kaymies/swing_jump_win/CAD/Project Reference CAD/Gantry Reference/treadmill_pic.jpg

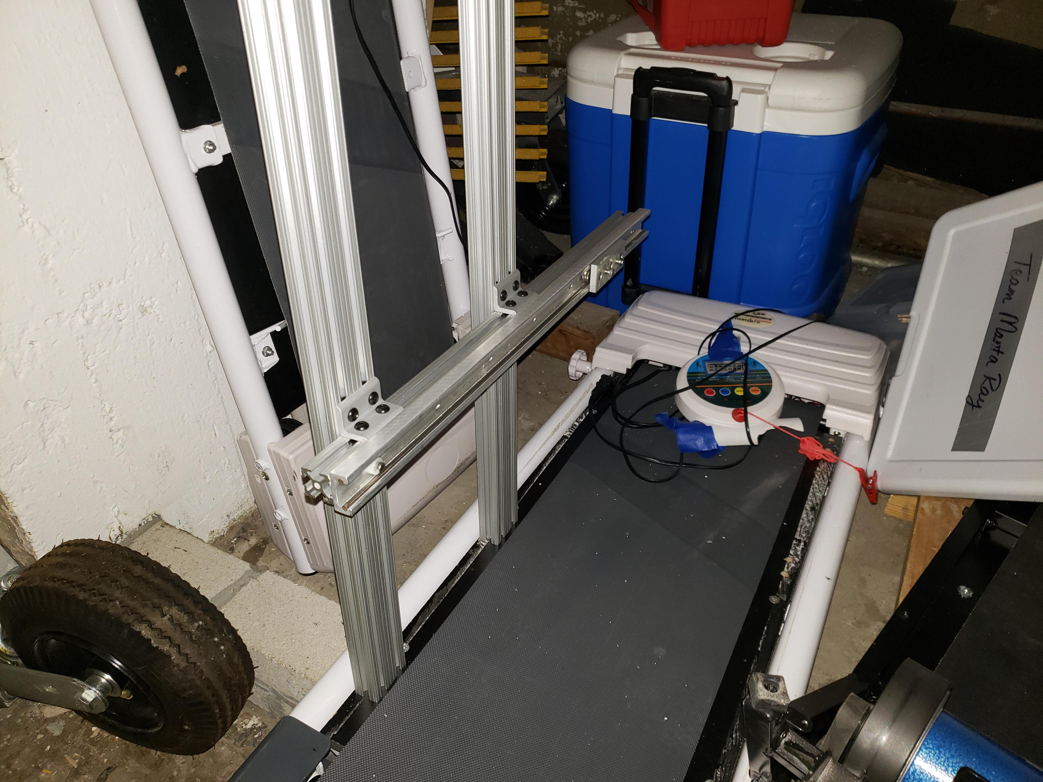
CAD/Project Reference CAD/Gantry Reference/treadmill_pic.jpg
