kaymies/swing_jump_win/README.md

# swing_jump_win
Code for simulating and programming a jumping robot with arms
