kaymies/swing_jump_win/CAD/modified_1dof_jumping_jig/Figures/Complete_1.PNG

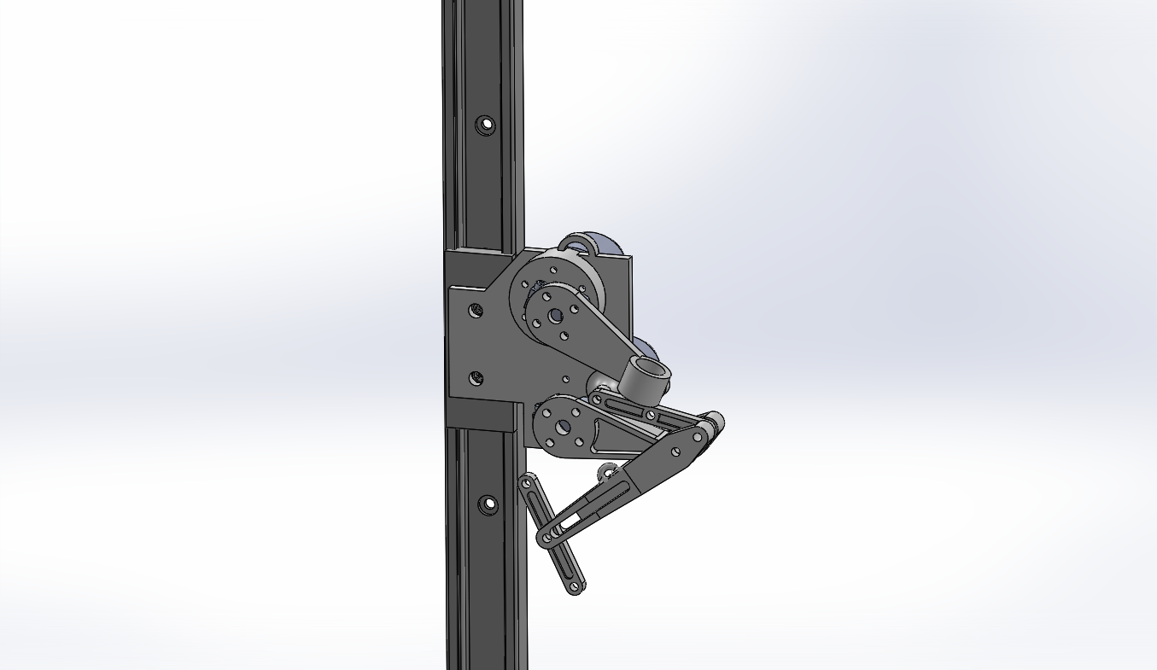
CAD/modified_1dof_jumping_jig/Figures/Complete_1.PNG
