kaymies/swing_jump_win/CAD/modified_1dof_jumping_jig/Figures/Complete_1_front.PNG

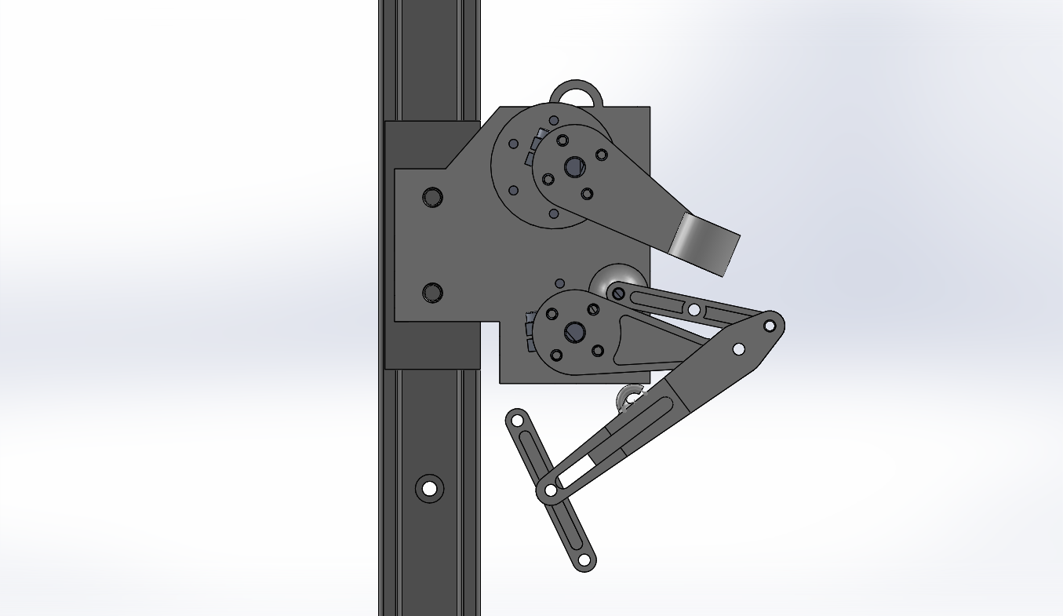
CAD/modified_1dof_jumping_jig/Figures/Complete_1_front.PNG
