kaymies/swing_jump_win/CAD/Project Reference CAD/Gantry Reference/Slider_pic.jpg

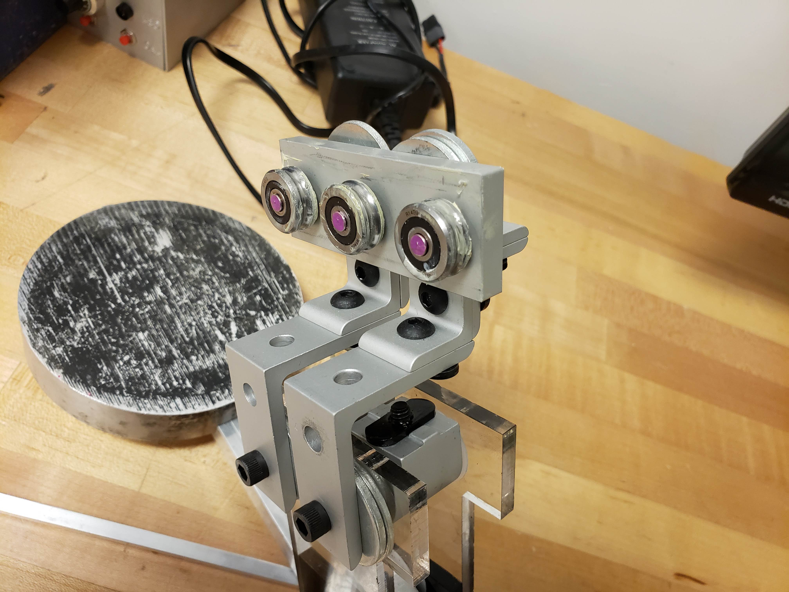
CAD/Project Reference CAD/Gantry Reference/Slider_pic.jpg
