kaymies/swing_jump_win/Modeling/Structure_Drawing.jpg

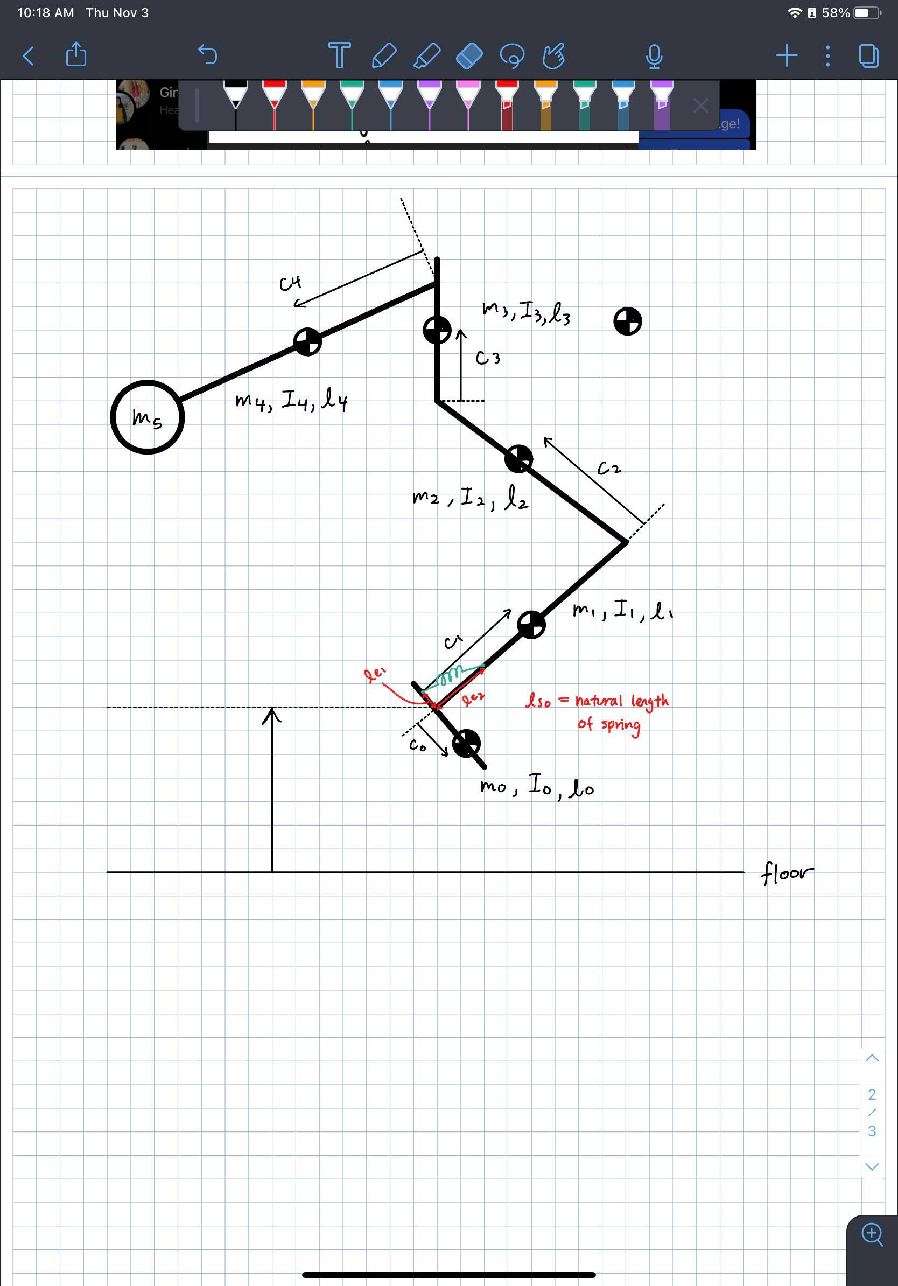
Modeling/Structure_Drawing.jpg
