kaymies/swing_jump_win/CAD/Material.txt

Pulley (Mcmaster):
https://www.mcmaster.com/3213T52
