kaymies/swing_jump_win/CAD/Project Reference CAD/Boom Reference/Reference_BOM.xlsx

Part | Quantity | Link or Part Number
Boom (repurposed phone tripod) | 1 | https://www.amazon.com/gp/product/B086Y8TL6M/ref=ppx_yo_dt_b_asin_title_o01_s00?ie=UTF8&psc=1
Bushing | 1 | McMaster Carr 1677K333
Dowel pin | 1 | McMaster Carr 98381A632
Washers | 2 | McMaster Carr 92141A031
8020 aluminum | 1-3 feet total | McMaster Carr 47605T101, 47605T102, 47605T107, or similar
Bracket piece 1 | 1 | 3D printed
Bracket piece 2 | 1 | 3D printed
8020 nuts | 2 | McMaster Carr 47065T905
Long bolts for brackets (1/4-20) | 2 | McMaster Carr 91251A550
Other 8020 hardware
