kaymies/swing_jump_win/CAD/Project Reference CAD/Gantry Reference/Reference_BOM.xlsx

Part | Quantity | Link or Part Number
Rail | 1 | McMaster Carr 6738K331
Carriage | 1 | McMaster Carr 6738K410
8020 aluminum | 4-6 feet total | McMaster Carr 47605T101, 47605T102, 47605T107, or similar
8020 nuts (10-32 hammer nuts) | 6 | McMaster Carr 5537T71
Bolts for mounting rail (10-32) | 6 | McMaster Carr 97763A231
Bolts for adapter (1/4-28) | 2 | McMaster Carr 91251A442
Leg adapter | 1 | 3D printed
Other 8020 hardware
