kaymies/swing_jump_win/CAD/modified_1dof_jumping_jig/Complete_1.SLDASM

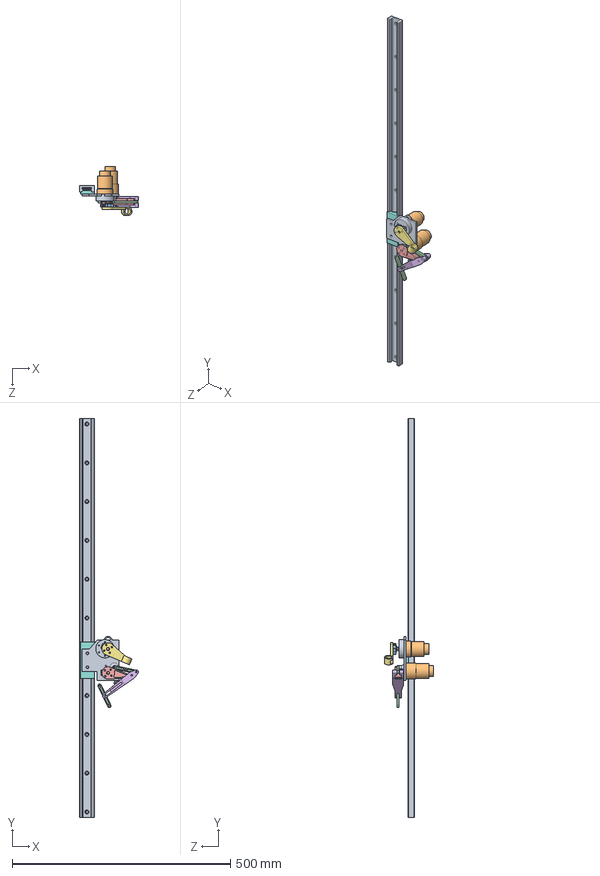
[picture p16: CAD file, 2022-12-08]
CAD/modified_1dof_jumping_jig/Complete_1.SLDASM
135.0 x 914.4 x 113.0 mm
Base
Motor x 2
motor clamping hub x 2
Link x 2
Thigh
Shin
Arm
6738K410_SIDE-MOUNT TRACK ROLLER CARRIAGE
6738K331_SIDE-MOUNT TRACK ROLLER CARRIAGE
