kaymies/swing_jump_win/CAD/single_motor_jumping_leg/Leg Assembly.SLDASM

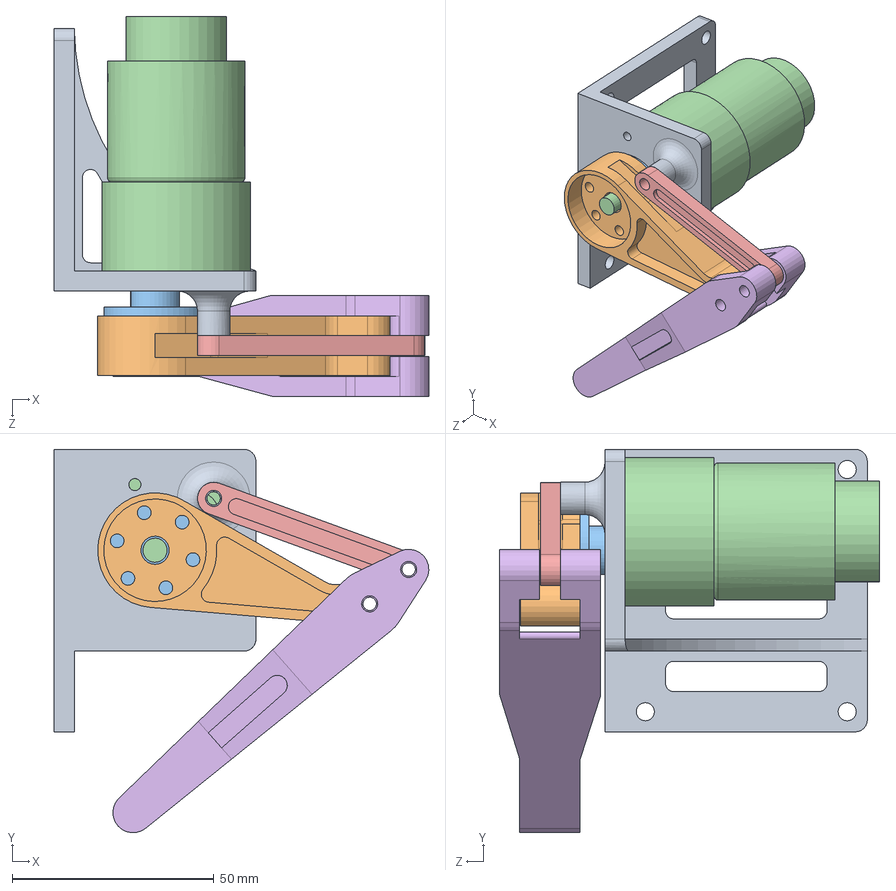
[picture p17: CAD file, 2022-10-31]
CAD/single_motor_jumping_leg/Leg Assembly.SLDASM
92.8 x 95.0 x 94.1 mm
Base
Thigh
Hub
Motor
Link
Shin
