kaymies/swing_jump_win/CAD/Project Reference CAD/Gantry Reference/Gantry_reference.SLDASM

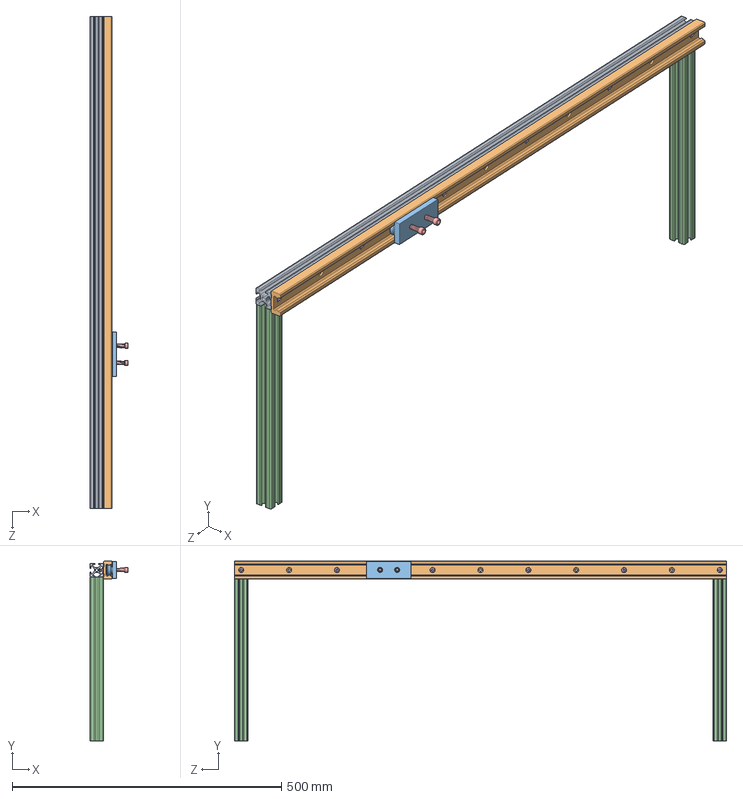
[picture p18: CAD file, 2022-10-31]
CAD/Project Reference CAD/Gantry Reference/Gantry_reference.SLDASM
71.1 x 334.4 x 914.4 mm
47065T412_ALUMINUM T-SLOTTED FRAMING EXTRUSION
6738K331_SIDE-MOUNT TRACK ROLLER CARRIAGE
6738K410_SIDE-MOUNT TRACK ROLLER CARRIAGE
47065T411_ALUMINUM T-SLOTTED FRAMING EXTRUSION x 2
91251A442_BLACK-OXIDE ALLOY STEEL SOCKET HEAD CAP SCREW x 2
97763A231_18-8 SS BUTTON HEAD HEX DRIVE SCREWS x 6
