kaymies/swing_jump_win/CAD/Project Reference CAD/Boom Reference/Boom_reference.SLDASM

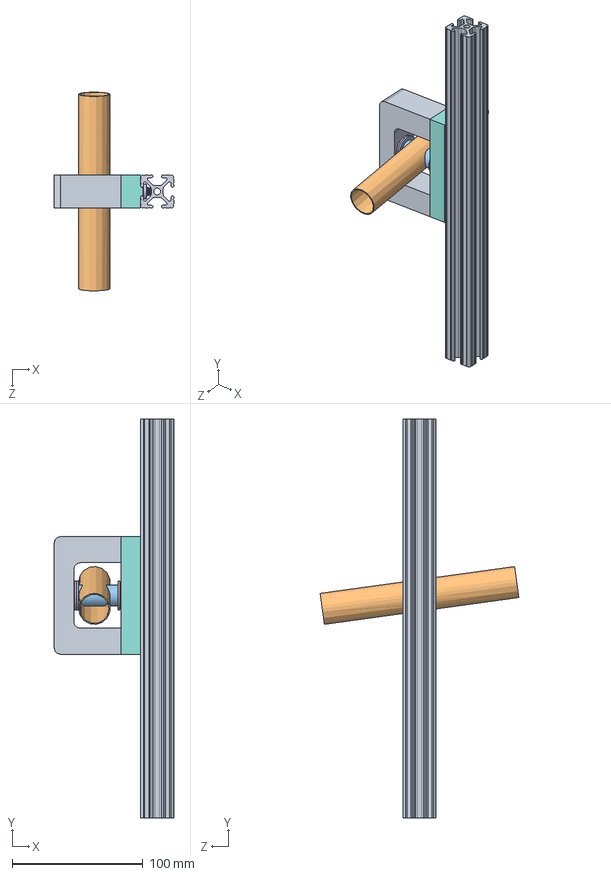
[picture p19: CAD file, 2022-10-31]
CAD/Project Reference CAD/Boom Reference/Boom_reference.SLDASM
91.4 x 304.8 x 151.9 mm
47065T411_ALUMINUM T-SLOTTED FRAMING EXTRUSION
Boom_piece
1677K333_ULTRA-LOW-FRICTION OIL-EMBEDDED SLEEVE BRNG
98381A632_ALLOY STEEL DOWEL PIN
92141A031_TYPE 18-8 STAINLESS STEEL FLAT WASHER x 2
47065T139_ALUMINUM T-SLOTTED FRAMING EXTRUSION x 2
91251A550_BLACK-OXIDE ALLOY STEEL SOCKET HEAD SCREW x 2
Bracket_inner_piece
Bracket_outer_piece
