kaymies/swing_jump_win/CAD/modified_1dof_jumping_jig/Base.SLDPRT

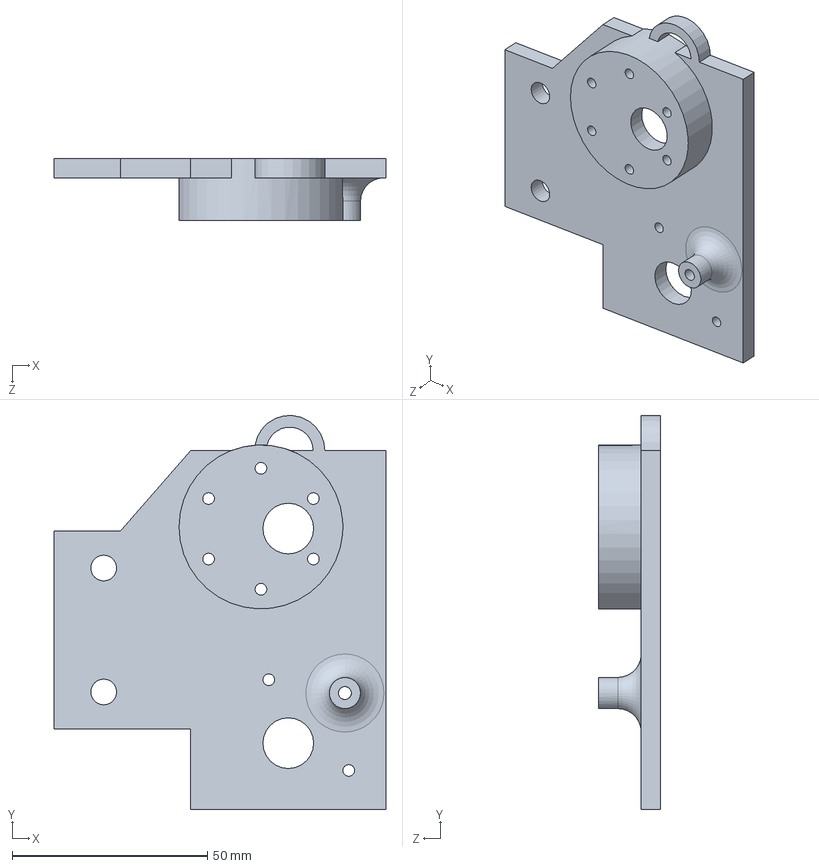
[picture p20: CAD file, 2022-12-08]
CAD/modified_1dof_jumping_jig/Base.SLDPRT
85.0 x 101.0 x 16.0 mm
