kaymies/swing_jump_win/CAD/modified_1dof_jumping_jig/STL Files/Shin2.STL

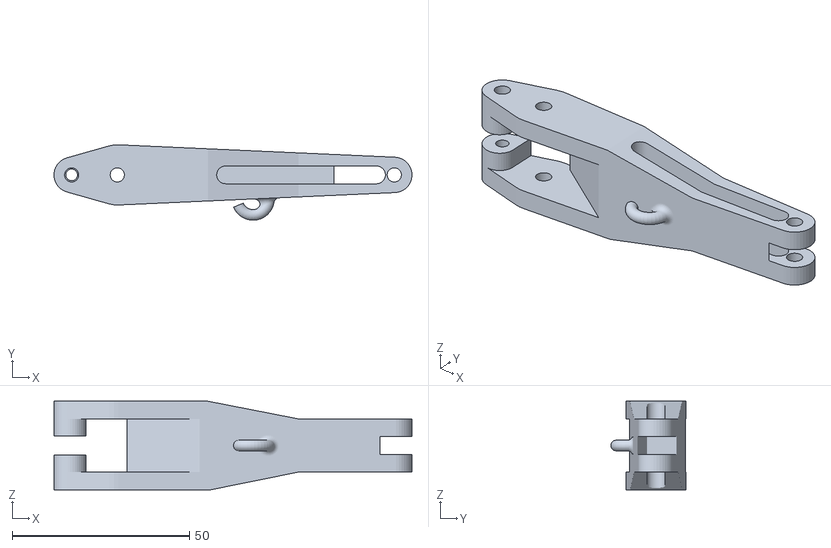
[picture p21: CAD file, 2022-11-15]
CAD/modified_1dof_jumping_jig/STL Files/Shin2.STL
101.0 x 21.3 x 25.0
