kaymies/swing_jump_win/CAD/single_motor_jumping_leg/motor clamping hub.SLDPRT

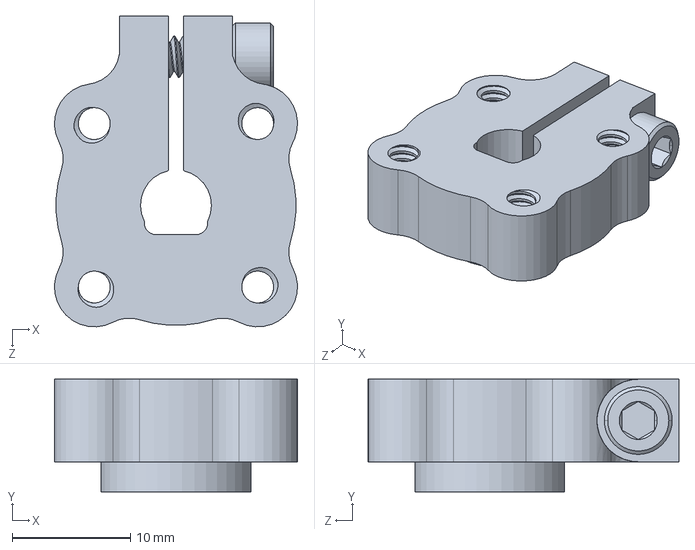
[picture p22: CAD file, 2022-10-31]
CAD/single_motor_jumping_leg/motor clamping hub.SLDPRT
20.6 x 9.53 x 26.3 mm
