kaymies/swing_jump_win/CAD/modified_1dof_jumping_jig/STL Files/Link2.STL

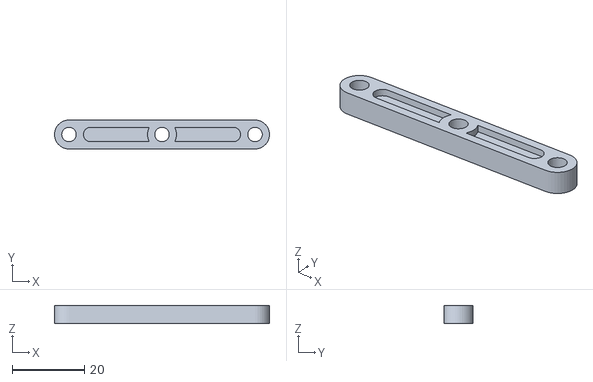
[picture p23: CAD file, 2022-11-10]
CAD/modified_1dof_jumping_jig/STL Files/Link2.STL
59.4 x 8.00 x 5.00
