kaymies/swing_jump_win/CAD/Project Reference CAD/Boom Reference/Boom_piece.SLDPRT

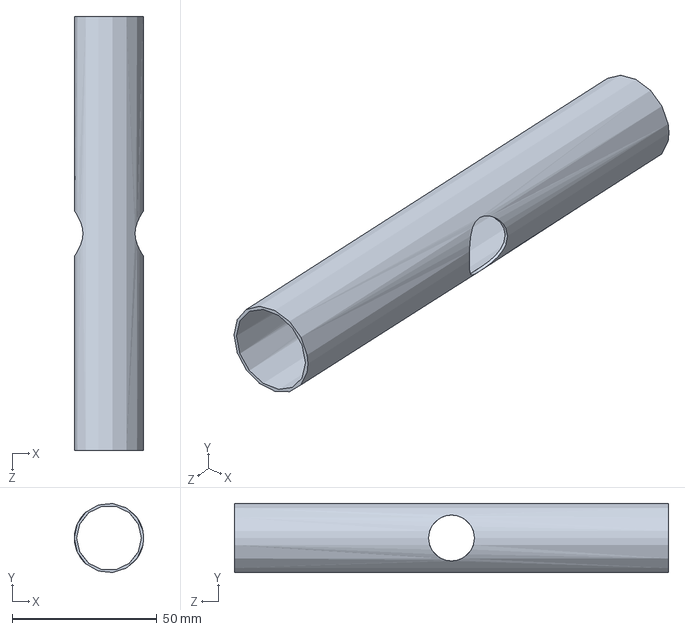
[picture p24: CAD file, 2022-10-31]
CAD/Project Reference CAD/Boom Reference/Boom_piece.SLDPRT
24.0 x 23.9 x 150.0 mm
