kaymies/swing_jump_win/CAD/single_motor_jumping_leg/Thigh.SLDPRT

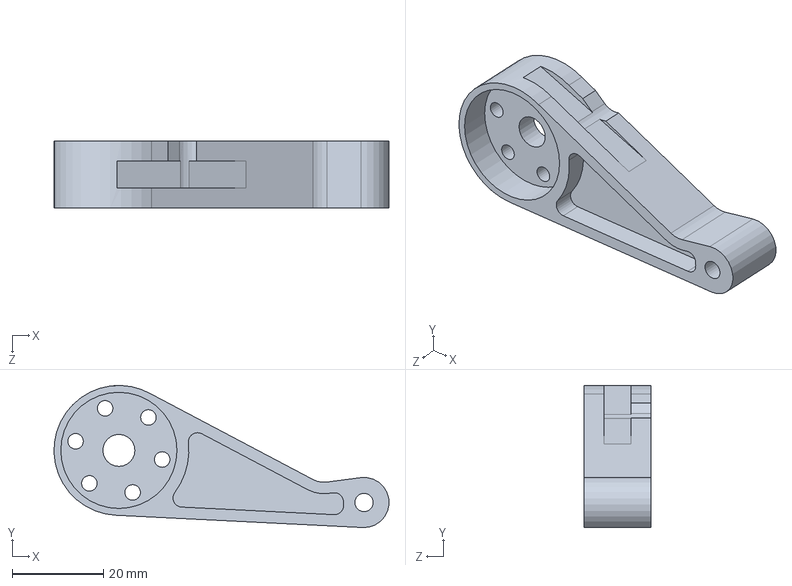
[picture p25: CAD file, 2022-10-31]
CAD/single_motor_jumping_leg/Thigh.SLDPRT
73.2 x 31.1 x 14.8 mm
