kaymies/swing_jump_win/CAD/modified_1dof_jumping_jig/pulley jig.SLDPRT

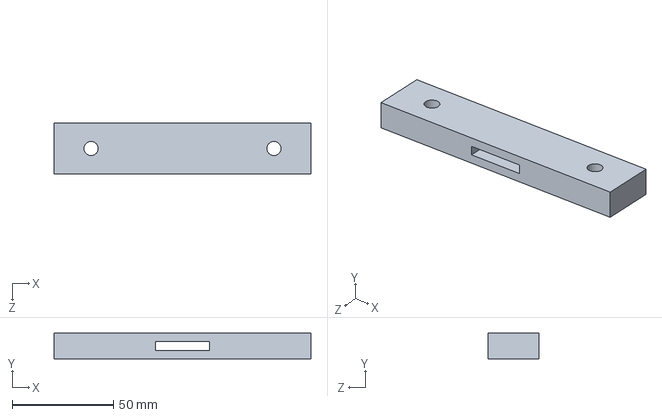
[picture p26: CAD file, 2022-11-22]
CAD/modified_1dof_jumping_jig/pulley jig.SLDPRT
127.0 x 12.7 x 25.4 mm
