kaymies/swing_jump_win/CAD/modified_1dof_jumping_jig/Shin-improved.SLDPRT

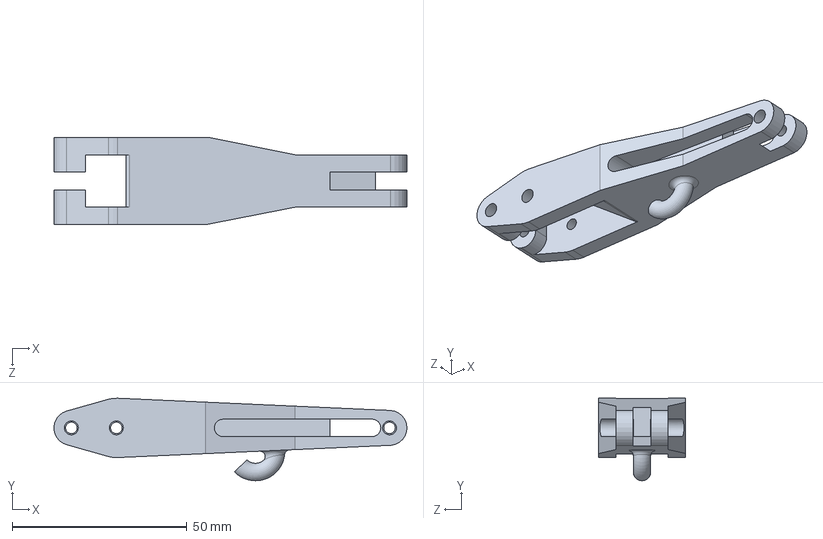
[picture p27: CAD file, 2022-11-15]
CAD/modified_1dof_jumping_jig/Shin-improved.SLDPRT
101.0 x 23.6 x 25.0 mm
