kaymies/swing_jump_win/CAD/Project Reference CAD/Boom Reference/Bracket_outer_piece.SLDPRT

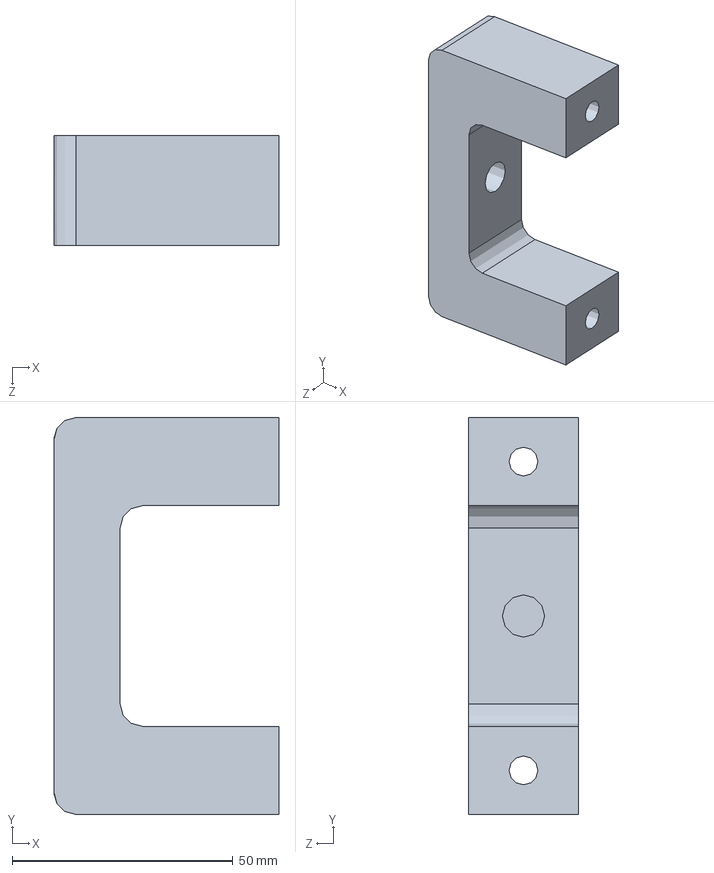
[picture p28: CAD file, 2022-10-31]
CAD/Project Reference CAD/Boom Reference/Bracket_outer_piece.SLDPRT
51.0 x 90.0 x 25.0 mm
