kaymies/swing_jump_win/CAD/Project Reference CAD/Leg Reference/hip_new.SLDPRT

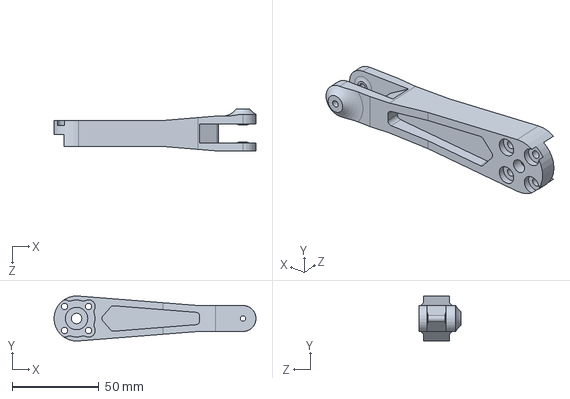
[picture p29: CAD file, 2022-10-31]
CAD/Project Reference CAD/Leg Reference/hip_new.SLDPRT
116.5 x 25.9 x 24.0 mm
