kaymies/swing_jump_win/CAD/single_motor_jumping_leg/Base.SLDPRT

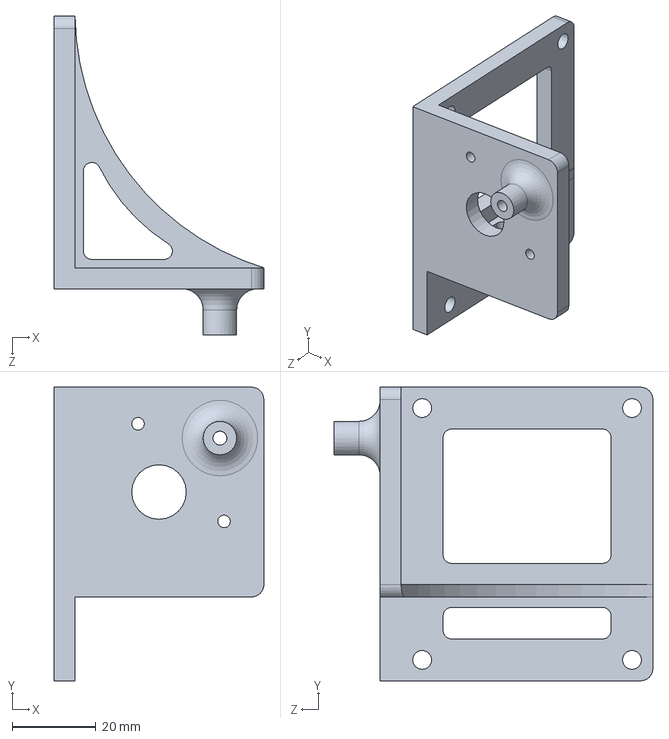
[picture p30: CAD file, 2022-10-31]
CAD/single_motor_jumping_leg/Base.SLDPRT
50.0 x 70.0 x 76.0 mm
