kaymies/swing_jump_win/CAD/modified_1dof_jumping_jig/Arm.SLDPRT

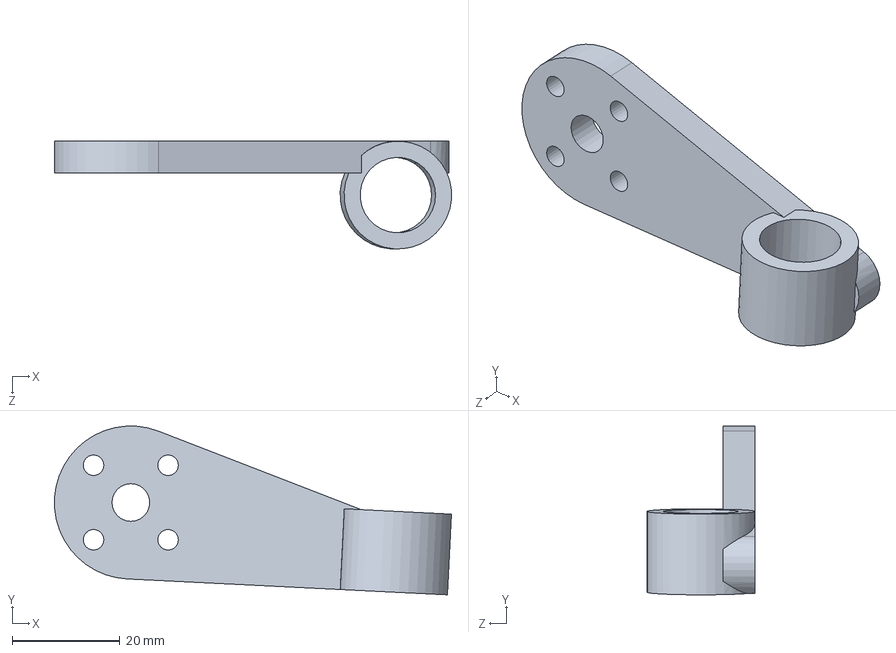
[picture p31: CAD file, 2022-11-10]
CAD/modified_1dof_jumping_jig/Arm.SLDPRT
73.7 x 31.3 x 20.0 mm
