kaymies/swing_jump_win/CAD/Project Reference CAD/Leg Reference/lower_new.SLDPRT

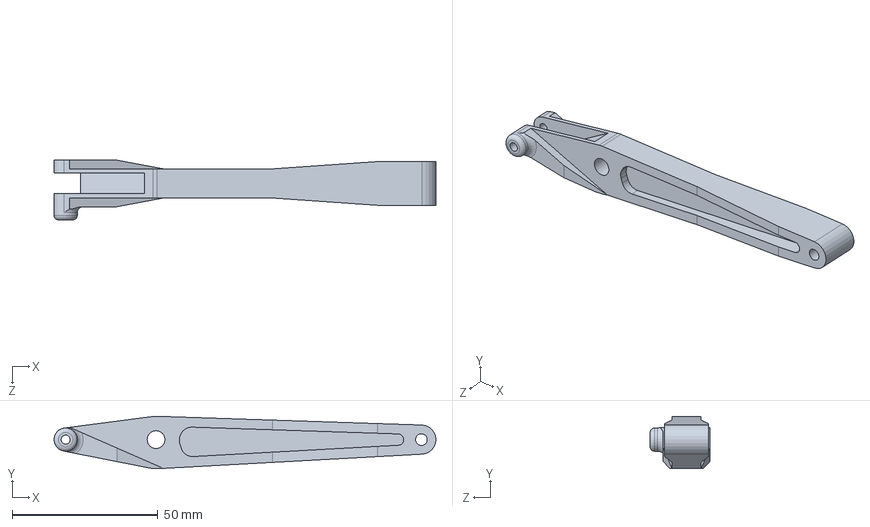
[picture p32: CAD file, 2022-10-31]
CAD/Project Reference CAD/Leg Reference/lower_new.SLDPRT
131.0 x 18.0 x 20.5 mm
