kaymies/swing_jump_win/CAD/single_motor_jumping_leg/Shin.SLDPRT

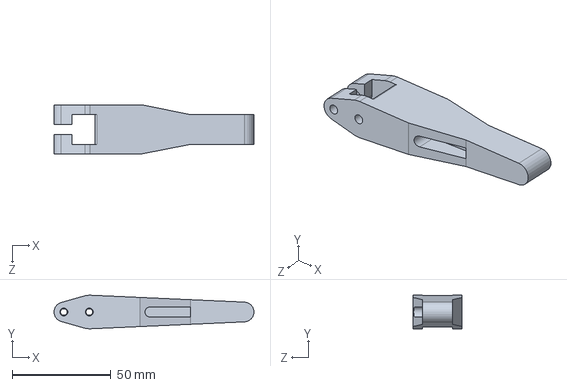
[picture p33: CAD file, 2022-10-31]
CAD/single_motor_jumping_leg/Shin.SLDPRT
101.0 x 17.0 x 25.0 mm
