kaymies/swing_jump_win/CAD/modified_1dof_jumping_jig/Thigh.SLDPRT

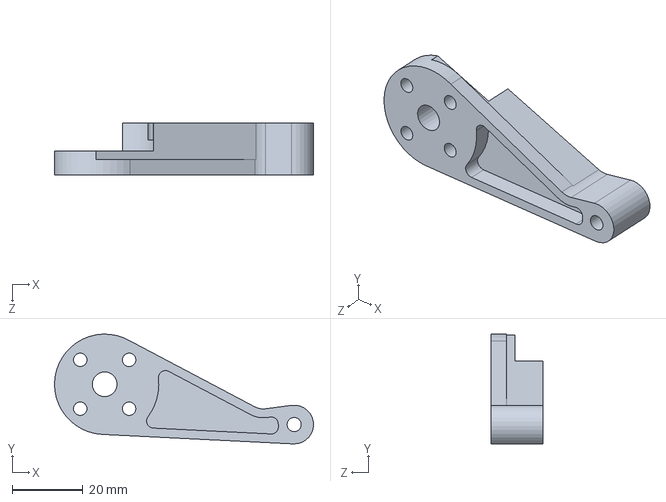
[picture p34: CAD file, 2022-11-10]
CAD/modified_1dof_jumping_jig/Thigh.SLDPRT
73.3 x 31.1 x 14.8 mm
