kaymies/swing_jump_win/CAD/Project Reference CAD/Boom Reference/Bracket_inner_piece.SLDPRT

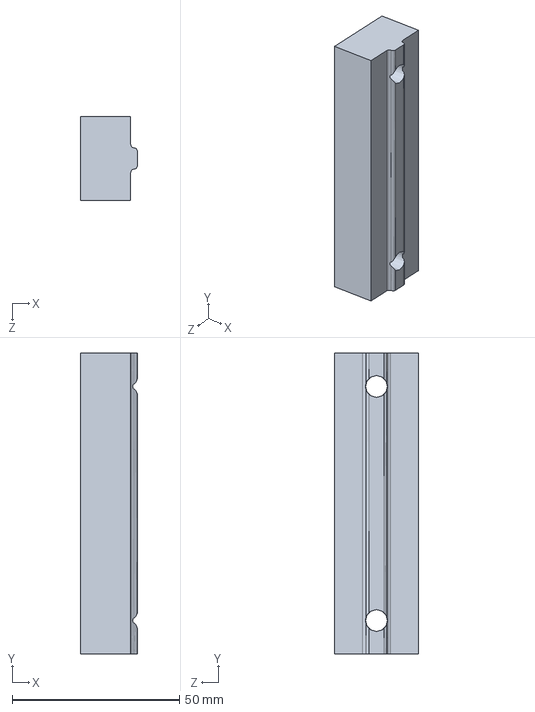
[picture p35: CAD file, 2022-10-31]
CAD/Project Reference CAD/Boom Reference/Bracket_inner_piece.SLDPRT
17.0 x 90.0 x 25.0 mm
