kaymies/swing_jump_win/CAD/single_motor_jumping_leg/Motor.SLDPRT

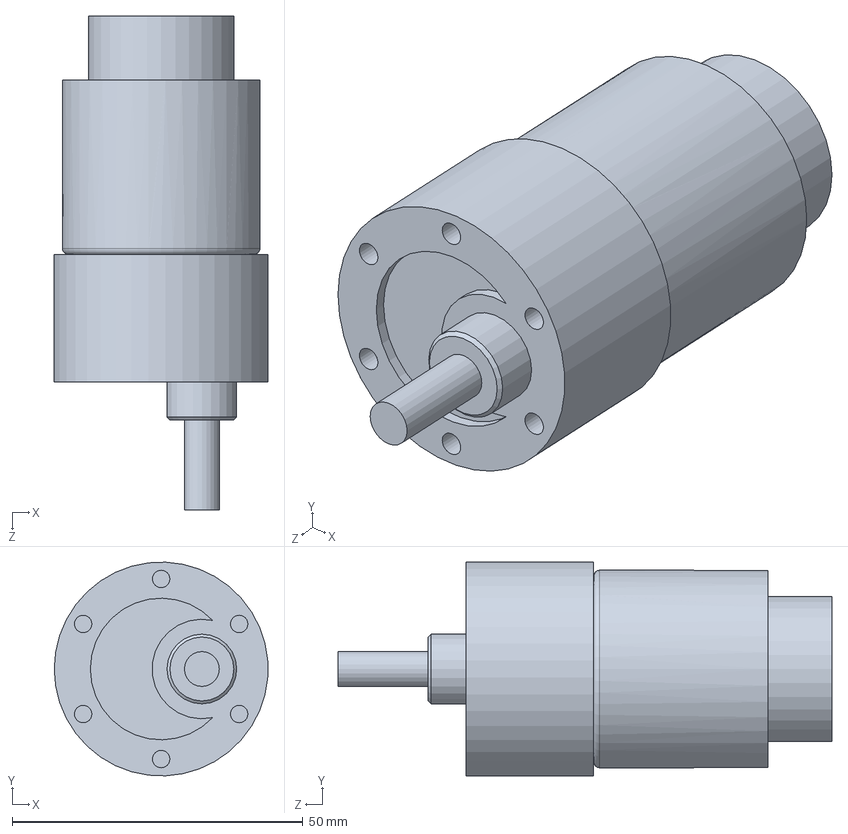
[picture p36: CAD file, 2022-10-31]
CAD/single_motor_jumping_leg/Motor.SLDPRT
36.7 x 36.8 x 85.0 mm
