kaymies/swing_jump_win/CAD/Project Reference CAD/Leg Reference/pololu-stamped-aluminum-l-bracket-for-37d-mm-metal-gearmotors.step.SLDPRT

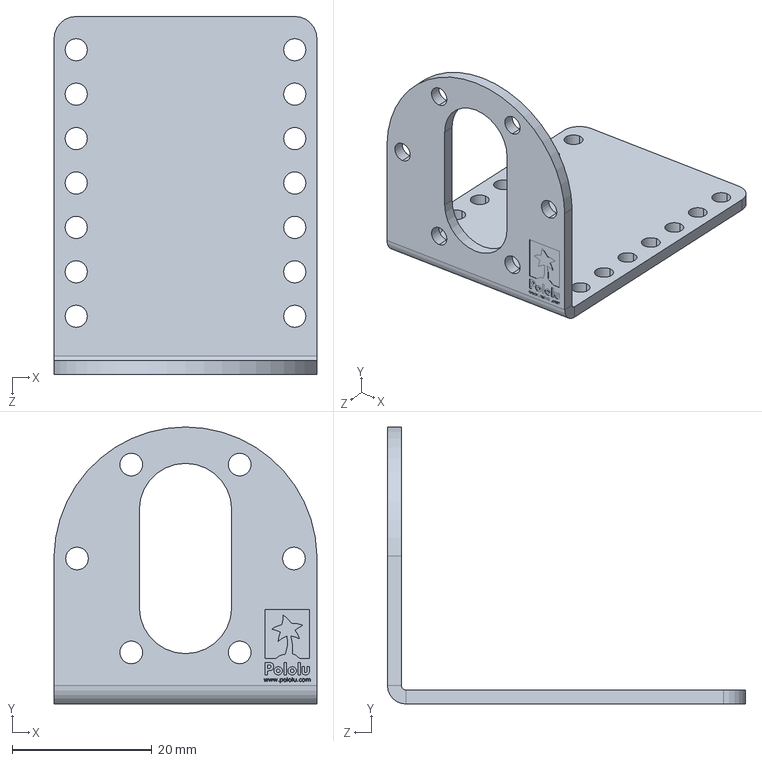
[picture p37: CAD file, 2022-10-31]
CAD/Project Reference CAD/Leg Reference/pololu-stamped-aluminum-l-bracket-for-37d-mm-metal-gearmotors.step.SLDPRT
37.6 x 39.6 x 51.2 mm
