kaymies/swing_jump_win/CAD/single_motor_jumping_leg/Hub.SLDPRT

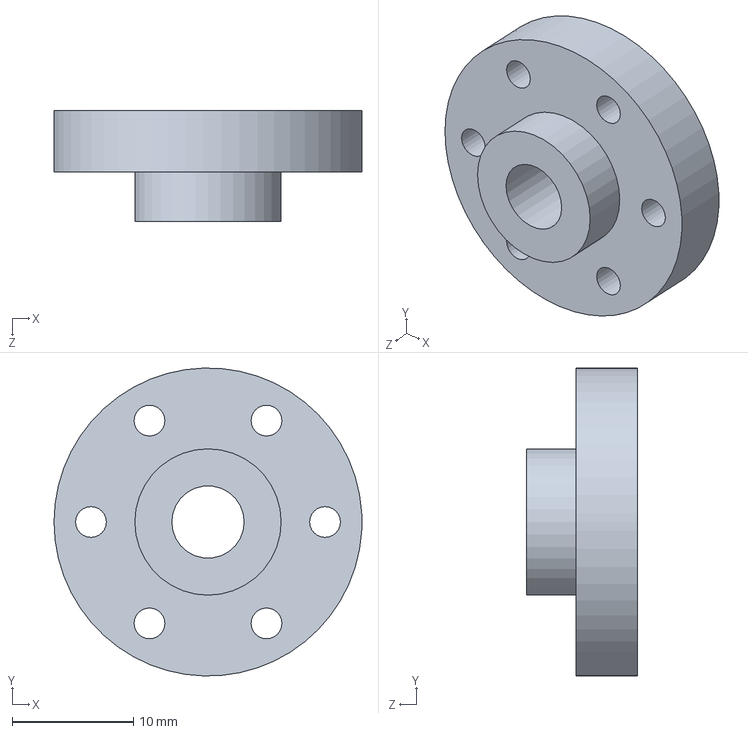
[picture p38: CAD file, 2022-10-31]
CAD/single_motor_jumping_leg/Hub.SLDPRT
25.4 x 25.4 x 9.14 mm
