kaymies/swing_jump_win/CAD/Project Reference CAD/Leg Reference/Linkage_new.SLDPRT

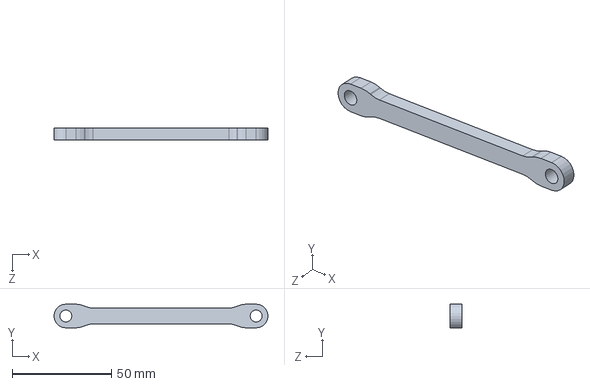
[picture p39: CAD file, 2022-10-31]
CAD/Project Reference CAD/Leg Reference/Linkage_new.SLDPRT
108.0 x 12.0 x 6.00 mm
