kaymies/swing_jump_win/CAD/modified_1dof_jumping_jig/InterMotor Link_new.SLDPRT

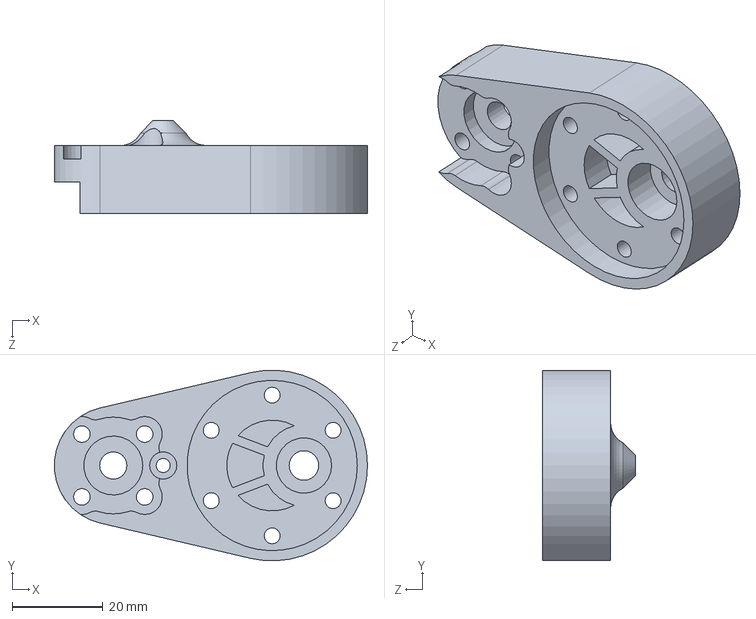
[picture p40: CAD file, 2022-10-31]
CAD/modified_1dof_jumping_jig/InterMotor Link_new.SLDPRT
68.9 x 42.0 x 20.5 mm
