kaymies/swing_jump_win/(list of files, cad)

Other CAD files:
CAD/single_motor_jumping_leg/Link.SLDPRT
CAD/modified_1dof_jumping_jig/Shin.SLDPRT
CAD/modified_1dof_jumping_jig/Link.SLDPRT
CAD/modified_1dof_jumping_jig/motor clamping hub.SLDPRT
CAD/modified_1dof_jumping_jig/Motor.SLDPRT
CAD/Project Reference CAD/Leg Reference/Motor.SLDPRT
CAD/Project Reference CAD/Boom Reference/1677K333_ULTRA-LOW-FRICTION OIL-EMBEDDED SLEEVE BRNG.SLDPRT
CAD/Project Reference CAD/Boom Reference/47065T139_ALUMINUM T-SLOTTED FRAMING EXTRUSION.SLDPRT
CAD/Project Reference CAD/Boom Reference/47065T411_ALUMINUM T-SLOTTED FRAMING EXTRUSION.SLDPRT
CAD/Project Reference CAD/Boom Reference/91251A550_BLACK-OXIDE ALLOY STEEL SOCKET HEAD SCREW.SLDPRT
CAD/Project Reference CAD/Boom Reference/92141A031_TYPE 18-8 STAINLESS STEEL FLAT WASHER.SLDPRT
CAD/Project Reference CAD/Boom Reference/98381A632_ALLOY STEEL DOWEL PIN.SLDPRT
CAD/Project Reference CAD/Gantry Reference/47065T411_ALUMINUM T-SLOTTED FRAMING EXTRUSION.SLDPRT
CAD/Project Reference CAD/Gantry Reference/47065T412_ALUMINUM T-SLOTTED FRAMING EXTRUSION.SLDPRT
CAD/Project Reference CAD/Gantry Reference/6738K331_SIDE-MOUNT TRACK ROLLER CARRIAGE.SLDPRT
CAD/Project Reference CAD/Gantry Reference/91251A442_BLACK-OXIDE ALLOY STEEL SOCKET HEAD CAP SCREW.SLDPRT
CAD/Project Reference CAD/Gantry Reference/97763A231_18-8 SS BUTTON HEAD HEX DRIVE SCREWS.SLDPRT
CAD/Project Reference CAD/Leg Reference/6658K111_OIL-EMBEDDED SAE 841 BRONZE SLEEVE BEARING.SLDPRT
CAD/Project Reference CAD/Leg Reference/6658K721_OIL-EMBEDDED SLEEVE BEARING.SLDPRT
CAD/Project Reference CAD/Leg Reference/7804K124_STAINLESS STEEL BALL BEARING.SLDPRT
CAD/Project Reference CAD/Leg Reference/91290A115_BLACK-OXIDE CLASS 12.9 SOCKET HEAD CAP SCREW.SLDPRT
CAD/Project Reference CAD/Leg Reference/91772A146_18-8 SS PAN HEAD PHILLIPS MACHINE SCREW.SLDPRT
CAD/Project Reference CAD/Leg Reference/94180A307_HEAT-SET INSERTS FOR PLASTICS.SLDPRT
CAD/Project Reference CAD/Leg Reference/shoulder_3mm_12len_M2_92981A772_ALLOY STEEL SHOULDER SCREW.SLDPRT
CAD/Project Reference CAD/Leg Reference/shoulder_3mm_16len_M2_92981A773_ALLOY STEEL SHOULDER SCREW.SLDPRT
CAD/Project Reference CAD/Leg Reference/shoulder_3mm_6len_M2_92981A769_ALLOY STEEL SHOULDER SCREW.SLDPRT
CAD/Project Reference CAD/Leg Reference/shoulder_3mm_len20_M2_92981A774_ALLOY STEEL SHOULDER SCREW.SLDPRT
CAD/modified_1dof_jumping_jig/6738K331_SIDE-MOUNT TRACK ROLLER CARRIAGE.SLDPRT
CAD/modified_1dof_jumping_jig/6738K410_SIDE-MOUNT TRACK ROLLER CARRIAGE.SLDPRT
CAD/modified_1dof_jumping_jig/STL Files/Arm.STL
CAD/modified_1dof_jumping_jig/STL Files/Base.STL
CAD/modified_1dof_jumping_jig/STL Files/Link.STL
CAD/modified_1dof_jumping_jig/STL Files/Shin-improved.STL
CAD/modified_1dof_jumping_jig/STL Files/Shin.STL
CAD/modified_1dof_jumping_jig/STL Files/Thigh.STL
CAD/modified_1dof_jumping_jig/STL Files/pulley jig.STL
