kaymies/swing_jump_win/Jumpheight_experimental2.jpg

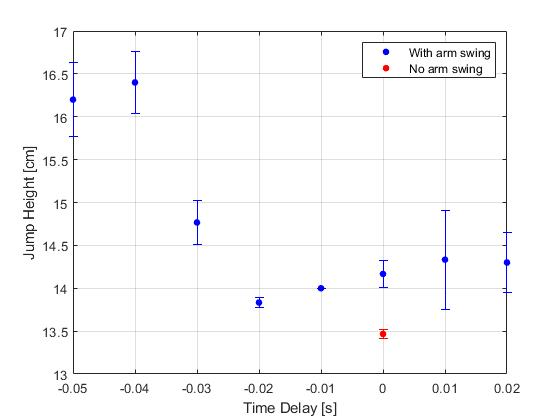
Jumpheight_experimental2.jpg
