kaymies/swing_jump_win/Jumpheight_experimental.jpg

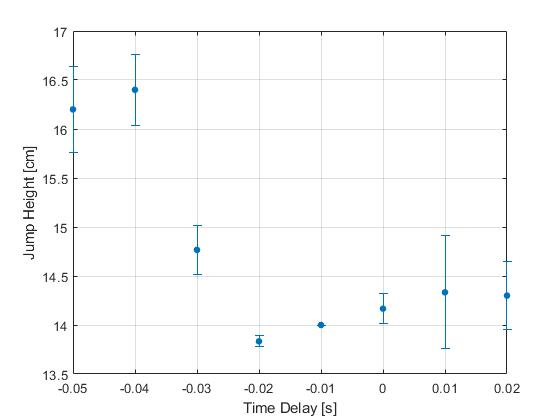
Jumpheight_experimental.jpg
