kaymies/swing_jump_win/(commit log)

2022-10-31 Create single_motor_jumping_leg (1).zip
    Added 1dof leg file
2022-10-31 deleted cad 1dof leg
    deleted cad 1dof leg
2022-10-31 Made cad folder
2022-10-31 expanded cad zip
    [Base.SLDPRT, Hub.SLDPRT, Leg Assembly.SLDASM, Link.SLDPRT, Motor.SLDPRT, Shin.SLDPRT, Thigh.SLDPRT]
2022-10-31 added reference
    [1677K333_ULTRA-LOW-FRICTION OIL-EMBEDDED SLEEVE BRNG.SLDPRT, 47065T139_ALUMINUM T-SLOTTED FRAMING EXTRUSION.SLDPRT, 47065T411_ALUMINUM T-SLOTTED FRAMING EXTRUSION.SLDPRT, 47065T412_ALUMINUM T-SLOTTED FRAMING EXTRUSION.SLDPRT, 6658K111_OIL-EMBEDDED SAE 841 BRONZE SLEEVE BEARING.SLDPRT, 6658K721_OIL-EMBEDDED SLEEVE BEARING.SLDPRT, 6738K331_SIDE-MOUNT TRACK ROLLER CARRIAGE.SLDPRT, 6738K410_SIDE-MOUN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]
2022-11-01 added foot, arm, torso to derive_everything and ran
2022-11-01 CAD updated for complete prototype
    [6738K410_SIDE-MOUNT TRACK ROLLER CARRIAGE.SLDPRT, Arm.SLDPRT, Base.SLDPRT, Complete_1.SLDASM, InterMotor Link_new.SLDPRT, Link.SLDPRT, Motor.SLDPRT, Shin.SLDPRT]
2022-11-03 CAD edits
    [Base.SLDPRT, Complete_1.SLDASM, Shin.SLDPRT]
2022-11-04 Surveyed parameters
    Everything except for spring k and spring l0
2022-11-07 Updated parts
    updated shin and base
    [Arm.SLDPRT, Arm.STL, Base.SLDPRT, Base.STL, Complete_1.SLDASM, Link.SLDPRT, Link.STL, Shin.SLDPRT]
2022-11-07 Fixed shin
    [Complete_1.SLDASM, Shin.SLDPRT, Shin.STL]
2022-11-07 changed link
    [Link.SLDPRT, Link.STL, Link2.STL]
2022-11-07 added arm fixture hole
    [Arm.SLDPRT, Arm.STL, Base.SLDPRT, Complete_1.SLDASM, Link.SLDPRT, Shin.SLDPRT, Thigh.SLDPRT]
2022-11-07 updated to add string hook
    [6738K331_SIDE-MOUNT TRACK ROLLER CARRIAGE.SLDPRT, 6738K410_SIDE-MOUNT TRACK ROLLER CARRIAGE.SLDPRT, Base.SLDPRT, Complete_1.SLDASM, Shin.SLDPRT, Shin.STL]
2022-11-07 Implementation update
    animation function - show spring and heel
    added joint limit constraints
2022-11-11 uploaded Gcode
    [Base.SLDPRT, Base.STL, Complete_1.SLDASM, Shin.STL]
2022-11-14 Updating torque cmd and matching params w expt
2022-11-14 ran parameter search for different ankle spring constants
2022-11-15 shin update
    [Shin-improved.SLDPRT, Shin-improved.STL, Shin2.STL]
2022-11-15 Made material doc
2022-11-22 updated base
    base now has fillet on weak joint
    [Base.SLDPRT, Base.STL, pulley jig.SLDPRT, pulley jig.STL]
2022-11-28 Edits to make sure adjusted model working
    Overall it's working. Some issues with ankle locking in place after landing but looks OK for takeoff part.
2022-11-29 Small fix, some parameter tests.
    Small hybrid model fix on arm. Parameter tests 8 and 4k
2022-11-29 Fixed derive, first "successful" param sweep
    Potential energy term was messed up after changing theta-ankle to relative. Fixed.
    Param sweep still noisy, I think because of (a) the system being chaotic naturally, with lost of different ways to "resonate" and (b) the arm swing is limited by the max motor torque (would be good to check that).
2022-12-02 added figs
    [Base.SLDPRT, Complete_1.SLDASM]
2022-12-02 Ran new parameters, varied shoulder omega
    Ran iterations with different stiffnesses, different leg segment lengths, see modelling analysis
    Added a PD control to have shoulder rotate at specified angular velocity.
2022-12-02 Second sweep for omega arm
2022-12-02 Pulled back to original arm swing
